Josue31052004/Proyecto-Carro/documentos/avances/Avance_II_-_MM.docx

Tecnológico de Costa Rica

Escuela de Ingeniería Mecatrónica

Curso: MT-7003 Microprocesadores y

Microcontroladores

Avance II Proyecto Microprocesador

Profesor: Carlos Adrián Salazar García

Estudiantes: Sergio Andrés García Acuña

Pablo Jacquinod González

Fernando Josué Rodríguez Camacho

Alejandro Zamora Llach

II Semestre, 2026

Proyecto Final de Curso

Carro con seguimiento de pista

- Criterios de selección

La selección del microcontrolador se realizó a partir de los requerimientos derivados del Avance I. El dispositivo debe contar con al menos cinco canales de conversión analógica-digital para el arreglo de sensores TCRT5000, generación de PWM independiente para los dos motorreductores a través del puente H L298N, soporte de interrupciones externas por ser un requisito obligatorio del curso, y al menos una interfaz RS-232, I²C o SPI para comunicarse con la Raspberry Pi. También se consideraron el costo, la disponibilidad y la facilidad de programación. Los tres candidatos se escogieron entre los disponibles en el proveedor local MicroJPM, verificando existencias. Se descartó la familia MSP430 de Texas Instruments porque no aparece en ese catálogo, y los dispositivos de la marca Arduino por restricción del enunciado.

- Comparación de los microcontroladores

Criterio | ESP32-WROOM-32 | STM32F103C8T6 | nRF52840 (Pro Mini)
Núcleo y frecuencia | Xtensa LX6 doble núcleo, 240 MHz | ARM Cortex-M3, 72 MHz | ARM Cortex-M4F, 64 MHz
Memoria | 520 KB SRAM / 4 MB Flash | 20 KB RAM / 64 KB Flash | 256 KB RAM / 1 MB Flash
Canales ADC | 12 bits, 18 canales | 12 bits, 10 canales | 12 bits, 8 canales
PWM | LEDC de 16 canales y MCPWM para motores | 4 temporizadores de 4 canales | 4 módulos de 4 canales, sin bloque de motores
Interrupciones | En todos los GPIO y temporizadores | Líneas EXTI compartidas entre puertos | GPIOTE, máximo 8 canales de evento
Comunicación | 3 UART, 2 I²C, 4 SPI | 3 USART, 2 I²C, 2 SPI | UARTE, 2 I²C, 4 SPI
Consumo | 3.3 V, unos 45 mA sin radio | 3.3 V, unos 30 mA | 3.3 V, bajo consumo sin radio
Programación | USB-UART integrado, ESP-IDF en C | Necesita programador ST-Link, STM32CubeIDE | Cargador UF2 por USB, nRF Connect SDK
Precio en MicroJPM | $15.95 | $16.95 más el programador | $43.95

- Justificación de la selección

Se selecciona el ESP32-WROOM-32 porque cubre los tres puntos críticos de la aplicación al menor costo. Primero, es el que ofrece la mayor cantidad de canales analógicos, suficientes para los cinco sensores TCRT5000 sin necesidad de multiplexar y con margen para ampliar el arreglo; como el proyecto no usa conectividad inalámbrica, los dos bloques de conversión quedan libres. Segundo, incluye el periférico MCPWM, un bloque de hardware dedicado al control de motores que permite sincronizar en fase las señales de ambos canales y deja abierta la captura de encoders para un control de velocidad en lazo cerrado. Ni el STM32F103 ni el nRF52840 tienen un bloque equivalente, por lo que habría que coordinar temporizadores de propósito general por software.

Tercero, el ESP32 admite interrupciones en cualquier GPIO, mientras que el STM32F103 comparte las líneas EXTI entre puertos y el nRF52840 limita los eventos de pin a ocho canales GPIOTE. A esto se suma el costo: el nRF52840 vale casi el triple y el STM32F103, aunque tiene un precio de tarjeta parecido, necesita un programador ST-Link externo que no se encontró en el catálogo del proveedor. El ESP32 trae el convertidor USB-UART integrado y se programa directamente por cable USB. El desarrollo se hará en lenguaje C sobre ESP-IDF.
