Josue31052004/Proyecto-Carro/raspberry-pi/legacy/README.md

Referencia del servidor Python anterior. No ejecutar para la version actual. La interfaz vigente esta en ../vista_control.hpp y se sirve directamente desde ciclo_main en puerto 8000.
