Josue31052004/Proyecto-Carro/CAD Files/Carro_Proyecto_Soporte_Camara_MM.SLDPRT

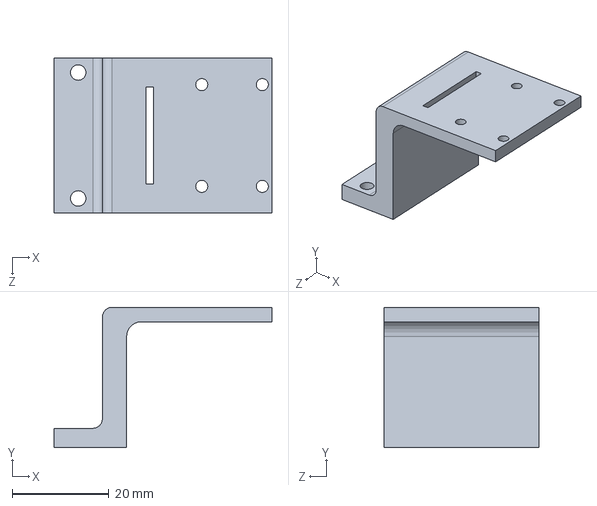
[picture p4: CAD file, 2026-10-28]
CAD Files/Carro_Proyecto_Soporte_Camara_MM.SLDPRT
45.0 x 29.0 x 32.0 mm
