Josue31052004/Proyecto-Carro/CAD Files/Carro_Proyecto_MM.SLDPRT

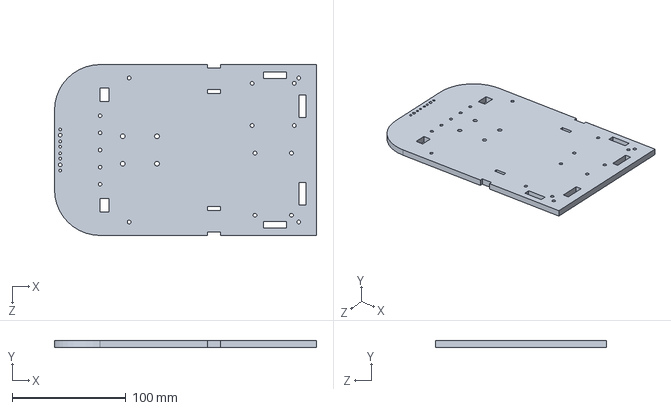
[picture p5: CAD file, 2026-10-28]
CAD Files/Carro_Proyecto_MM.SLDPRT
230.0 x 6.00 x 150.0 mm
