Josue31052004/Proyecto-Carro/CAD Files/Carro_Proyecto_Parte_Superior_MM.SLDPRT

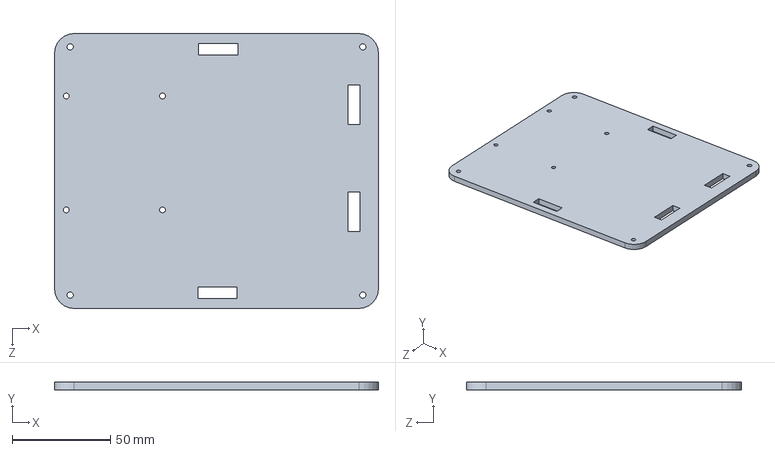
[picture p6: CAD file, 2026-10-28]
CAD Files/Carro_Proyecto_Parte_Superior_MM.SLDPRT
165.0 x 4.00 x 140.0 mm
