Josue31052004/Proyecto-Carro/(list of files, cad)

Other CAD files:
CAD Files/Carro_Proyecto_MM_VERSION3.STL
CAD Files/Carro_Proyecto_MM.STL
CAD Files/Carro_Proyecto_Parte_Superior_MM.STL
CAD Files/Carro_Proyecto_Soporte_Camara_MM.STL
