Josue31052004/Proyecto-Carro/bitacora/README.md

# Bitácora del grupo

La rúbrica de la entrega final asigna **5 puntos binarios** a este apartado:
*"Posee o no posee bitácora legible y completa"*. No se evalúa la calidad de lo
escrito, solo que exista y esté completa, así que conviene llenarla al día.

El enunciado pide registrar vivencias, toma de decisiones, anotaciones de
reuniones, cálculos y bosquejos.

## Cómo usarla

Una entrada por sesión de trabajo o reunión, en un archivo por fecha con el
formato `2026-10-26.md`. Abajo queda una plantilla.

---

## Plantilla

```markdown
# Sesión del DD de mes de 2026

**Participantes:** nombres de quienes estuvieron
**Duración:** de X a Y

## Qué se hizo

Descripción de lo trabajado.

## Decisiones tomadas

- Decisión, con la razón detrás y las alternativas que se descartaron.

## Problemas encontrados

- Qué falló y cómo se resolvió, o si quedó pendiente.

## Pendientes para la próxima sesión

- [ ] Tarea — responsable
```
