Josue31052004/Proyecto-Carro/recursos/diagramas/Diagrama_bloques_hardware.pdf

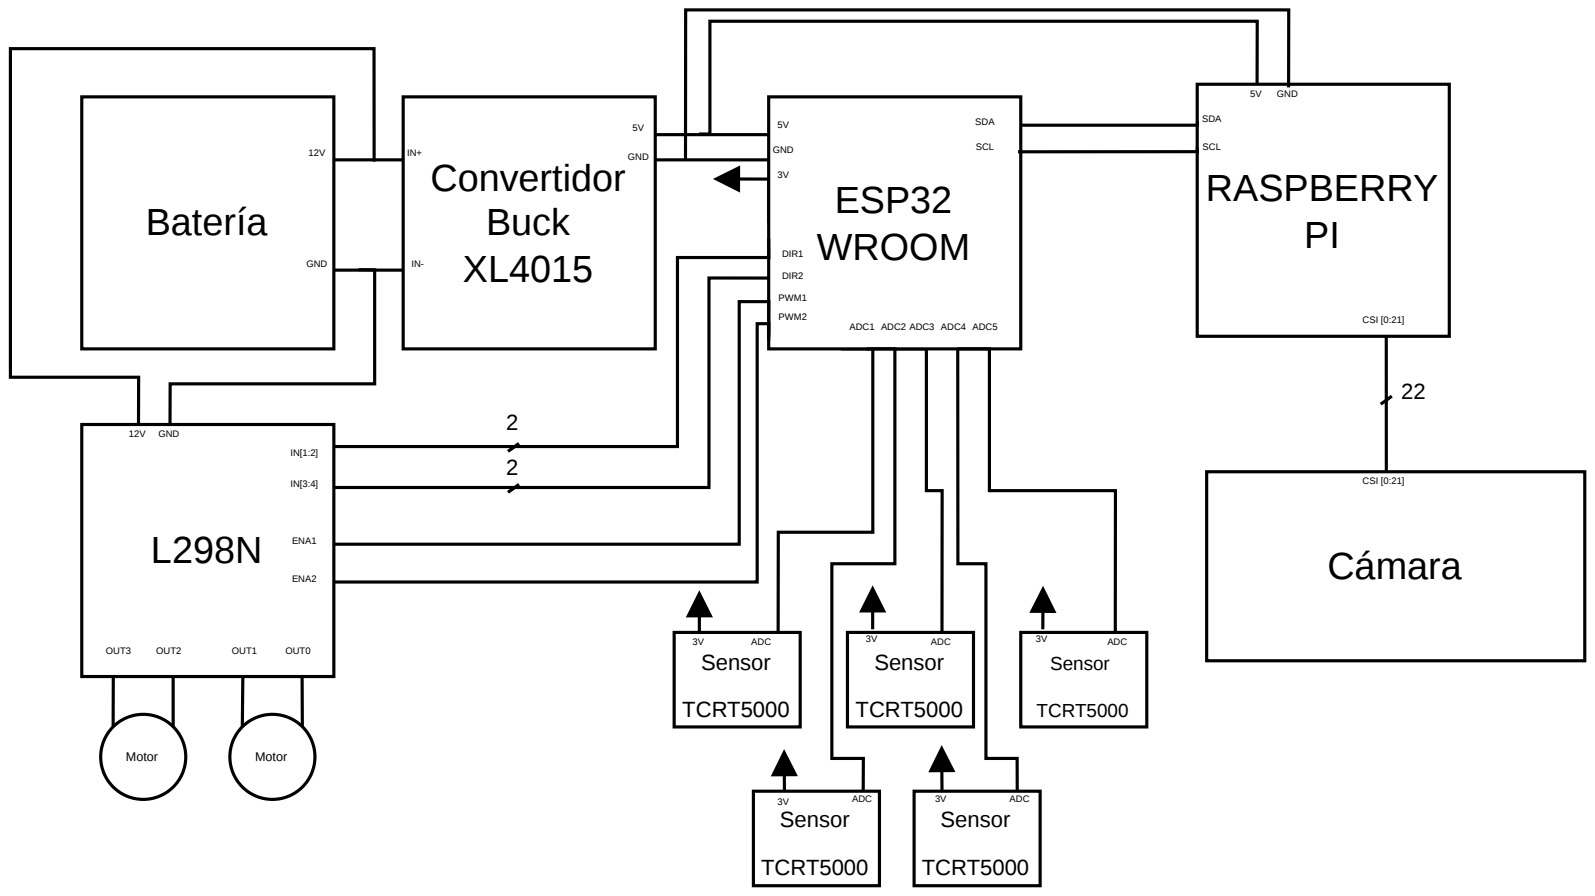
[picture p7: page 1]
ESP32 WROOM; Sensor; TCRT5000; ADC1 ADC2 ADC3 ADC4 ADC5; ADC; Batería; Convertidor Buck XL4015; GND; PWM1; PWM2; 12V GND; DIR1; DIR2; ENA1; ENA2; Motor; OUT3; OUT2; OUT1; OUT0; SDA; SCL; RASPBERRY PI; Cámara; CSI [0:21]
