Josue31052004/Proyecto-Carro/recursos/diagramas/Diagrama_flujo_ESP32.pdf

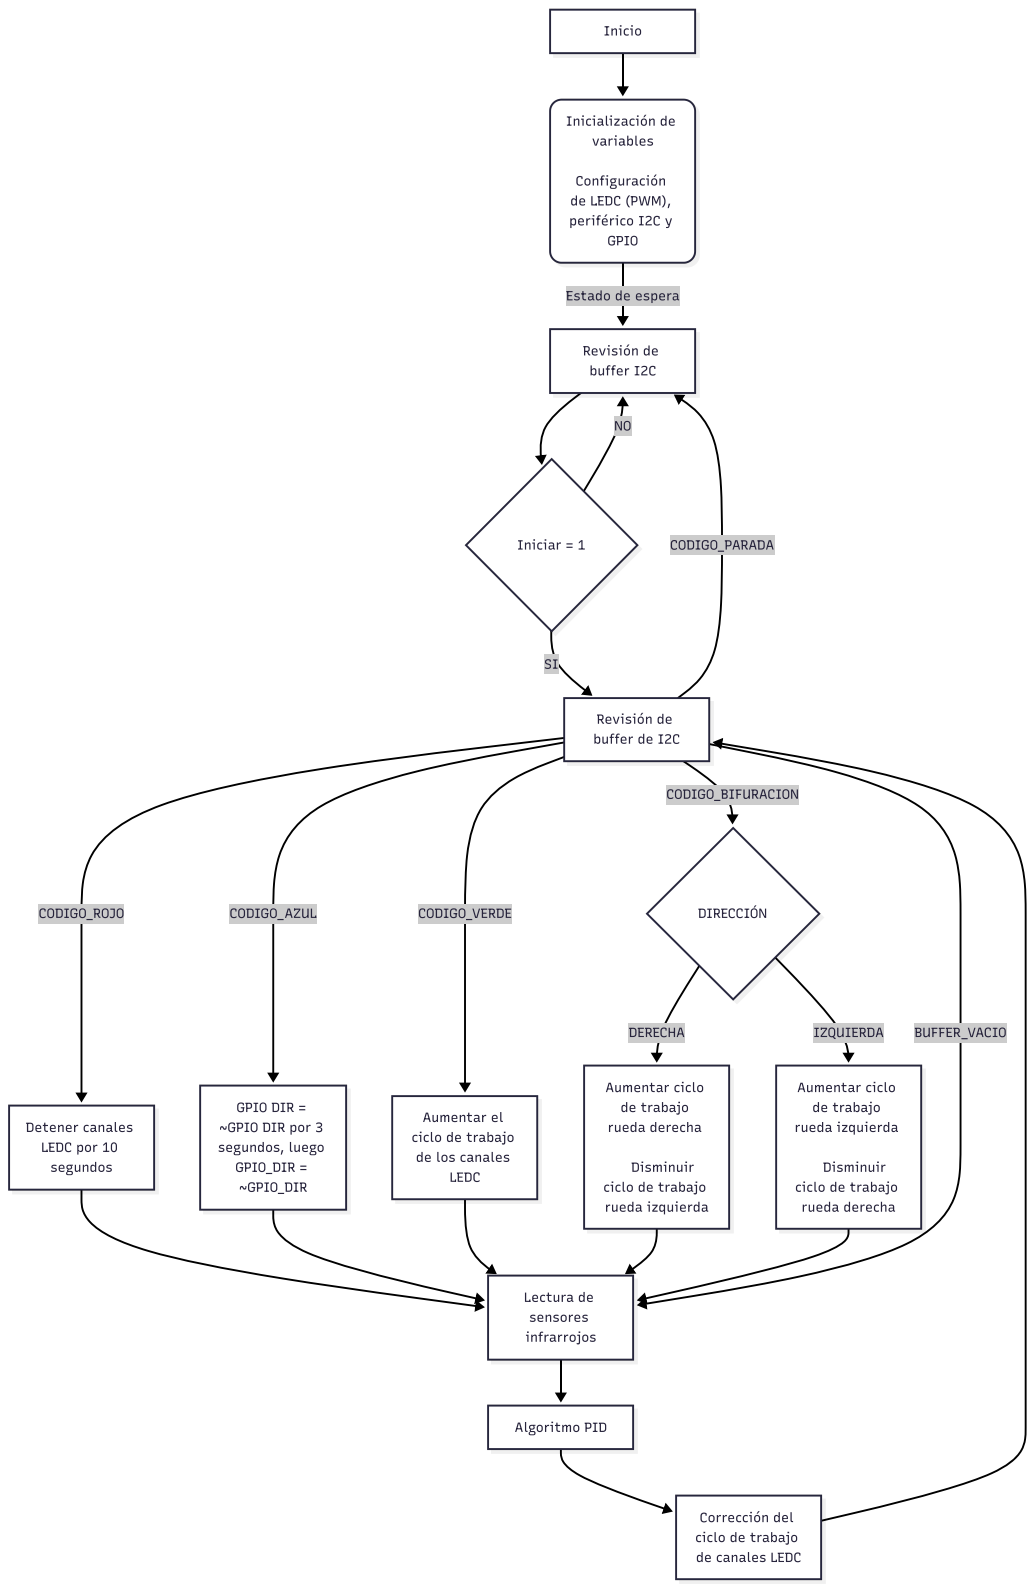
[picture p8: page 1]
CODIGO_ROJO; CODIGO_AZUL; CODIGO_VERDE; CODIGO_PARADA; CODIGO_BIFURACION; DERECHA; IZQUIERDA; BUFFER_VACIO; Inicio; Inicialización de; variables; GPIO; Revisión de; buffer I2C; Iniciar = 1; buffer de I2C; Detener canales; LEDC por 10; segundos; Lectura de; sensores; infrarrojos; GPIO DIR =; ~GPIO DIR por 3; segundos, luego; GPIO_DIR =; ~GPIO_DIR; LEDC; DIRECCIÓN; Aumentar ciclo; de trabajo; rueda derecha; rueda izquierda; Algoritmo PID

Configuración
de LEDC (PWM),
periférico I2C y

Estado de espera

Aumentar el
ciclo de trabajo
de los canales

Disminuir
rueda izquierda

rueda derecha

Corrección del
de canales LEDC
