Josue31052004/Proyecto-Carro/recursos/diagramas/Diagrama_flujo_RaspberryPi.pdf

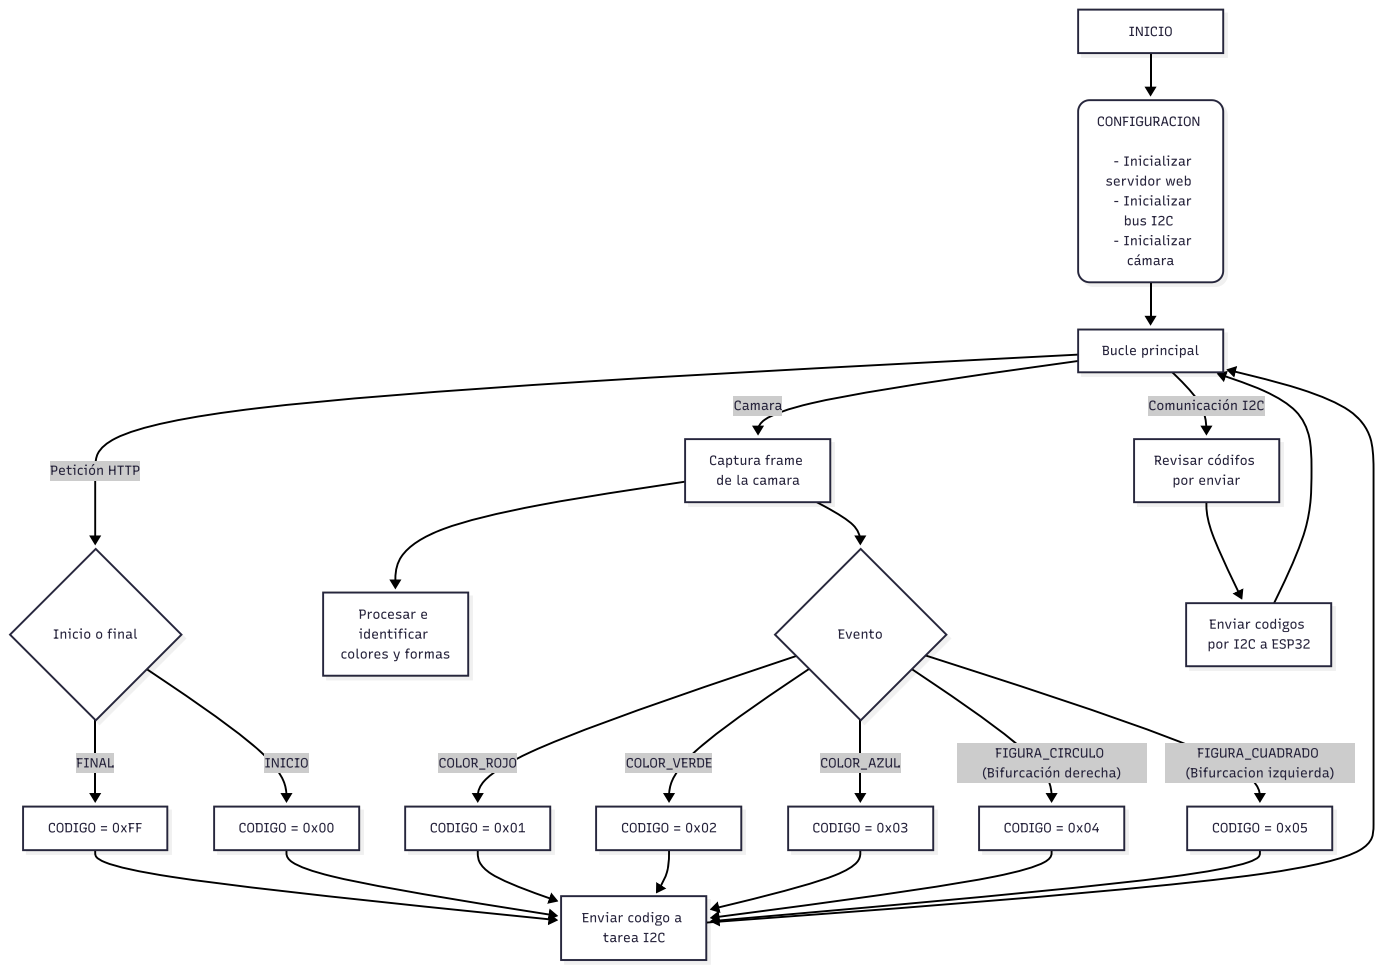
[picture p9: page 1]
Petición HTTP; FINAL; INICIO; Camara; COLOR_ROJO; COLOR_VERDE; COLOR_AZUL; FIGURA_CIRCULO; (Bifurcación derecha); FIGURA_CUADRADO; (Bifurcacion izquierda); Comunicación I2C; CONFIGURACION; - Inicializar; servidor web; bus I2C; cámara; Bucle principal; Inicio o final; CODIGO = 0xFF; Enviar codigo a; tarea I2C; CODIGO = 0x00; Procesar e; identificar; colores y formas; Evento; CODIGO = 0x01; CODIGO = 0x02; CODIGO = 0x03; CODIGO = 0x04; CODIGO = 0x05; Revisar códifos; por enviar; Enviar codigos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

Captura frame
de la camara
