Josue31052004/Proyecto-Carro/(commit log)

2026-10-23 Se añaden los archivos del esp32 con seguimiento de linea, manejo de motores y lectura de sensores
2026-10-25 Se agrega la bitacora del proyecto hasta el momento
2026-10-28 Update README.md
    Ajuste rapido en descripcion de proyecto
2026-10-28 Agregar demo funcional de colores y archivos CAD
    [Carro_Proyecto_MM.SLDPRT, Carro_Proyecto_MM.STL, Carro_Proyecto_MM_VERSION3.STL, Carro_Proyecto_Parte_Superior_MM.SLDPRT, Carro_Proyecto_Parte_Superior_MM.STL, Carro_Proyecto_Soporte_Camara_MM.SLDPRT, Carro_Proyecto_Soporte_Camara_MM.STL]
2026-10-28 Agrega amarillo como senal de bifurcacion
2026-10-28 Se aumento la velocidad y se ajustaron los parametros de seguimiento de linea
2026-10-28 Integra envio I2C real en el ciclo principal
2026-10-28 Ciclo Main con i2c version1
2026-10-28 Soporte i2c en el esp32
2026-10-28 Agrega demo de calibracion ajustable y guardado de valores
2026-10-29 Cambio de logica de bloqueo a evitar 2 codigos seguidos de frenado, reversa y cambio de velocidado
    [main.cpp]
2026-10-29 Cambio de fraccion minima y de cuadro de deteccion
